zhangry868/MultiCycleCPU/(list of files, cad)

Other CAD files:
Multiple_Cycles_CPU/simulation/modelsim/gate_work/@multiple_@cycles_@c@p@u_vlg_tst/verilog.psm
Multiple_Cycles_CPU/simulation/modelsim/rtl_work/@a@l@u/verilog.psm
Multiple_Cycles_CPU/simulation/modelsim/rtl_work/@a@l@u_@controller/verilog.psm
Multiple_Cycles_CPU/simulation/modelsim/rtl_work/@adder/verilog.psm
Multiple_Cycles_CPU/simulation/modelsim/rtl_work/@addr@reg/verilog.psm
Multiple_Cycles_CPU/simulation/modelsim/rtl_work/@controller/verilog.psm
Multiple_Cycles_CPU/simulation/modelsim/rtl_work/@ex@number/verilog.psm
Multiple_Cycles_CPU/simulation/modelsim/rtl_work/@i@register/verilog.psm
Multiple_Cycles_CPU/simulation/modelsim/rtl_work/@instru_@control/verilog.psm
Multiple_Cycles_CPU/simulation/modelsim/rtl_work/@judge@bit/verilog.psm
Multiple_Cycles_CPU/simulation/modelsim/rtl_work/@m@i@p@s_@register/verilog.psm
Multiple_Cycles_CPU/simulation/modelsim/rtl_work/@m@i@p@s_@shifter/verilog.psm
Multiple_Cycles_CPU/simulation/modelsim/rtl_work/@m@u@x4_1/verilog.psm
Multiple_Cycles_CPU/simulation/modelsim/rtl_work/@m@u@x4_1_32bit/verilog.psm
Multiple_Cycles_CPU/simulation/modelsim/rtl_work/@m@u@x4_1_5bit/verilog.psm
Multiple_Cycles_CPU/simulation/modelsim/rtl_work/@m@u@x4_1_@i@control/verilog.psm
Multiple_Cycles_CPU/simulation/modelsim/rtl_work/@m@u@x8_1/verilog.psm
Multiple_Cycles_CPU/simulation/modelsim/rtl_work/@m@u@x8_1_32/verilog.psm
Multiple_Cycles_CPU/simulation/modelsim/rtl_work/@m@u@x8_1_@a@l@u/verilog.psm
Multiple_Cycles_CPU/simulation/modelsim/rtl_work/@m@u@x8_1_@single/verilog.psm
Multiple_Cycles_CPU/simulation/modelsim/rtl_work/@memory/verilog.psm
Multiple_Cycles_CPU/simulation/modelsim/rtl_work/@memory_@shift@output/verilog.psm
Multiple_Cycles_CPU/simulation/modelsim/rtl_work/@multiple_@cycles_@c@p@u/verilog.psm
Multiple_Cycles_CPU/simulation/modelsim/rtl_work/@multiple_@cycles_@c@p@u_vlg_tst/verilog.psm
Multiple_Cycles_CPU/simulation/modelsim/rtl_work/@mux4_1/verilog.psm
Multiple_Cycles_CPU/simulation/modelsim/rtl_work/@p@c/verilog.psm
Multiple_Cycles_CPU/simulation/modelsim/rtl_work/@register_@shift@output/verilog.psm
