zhangry868/MultiCycleCPU/Multiple_Cycles_CPU/simulation/modelsim/rtl_work/@memory/_primary.vhd

library verilog;
use verilog.vl_types.all;
entity Memory is
    generic(
        DATA_WIDTH      : integer := 32;
        ADDR_WIDTH      : integer := 32
    );
    port(
        data            : in     vl_logic_vector;
        addr            : in     vl_logic_vector;
        we              : in     vl_logic_vector(3 downto 0);
        clk             : in     vl_logic;
        q               : out    vl_logic_vector
    );
    attribute mti_svvh_generic_type : integer;
    attribute mti_svvh_generic_type of DATA_WIDTH : constant is 1;
    attribute mti_svvh_generic_type of ADDR_WIDTH : constant is 1;
end Memory;
